fjaderboll/lora-beetle-e1/board/prototype.md

# Prototype
Home-made circuit board for testing only.
For the final one, look [here](README.md).

## Top
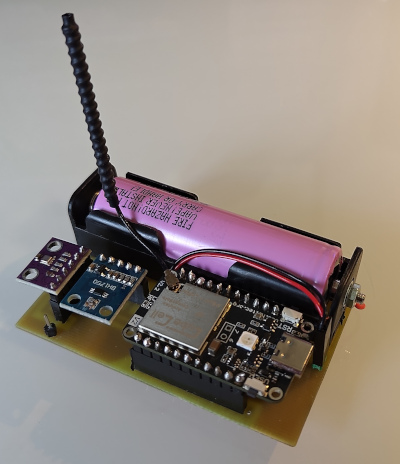
[picture p12: board/images/prototype-top.jpg]
Prototype board, top


## Bottom
Prototype board, bottom
