fjaderboll/lora-beetle-e1/doc/prototype.md

# Prototype
Home-made circuit board for testing only.
For the final one, look [here](../board/README.md).

## Top
Prototype board, top

## Bottom
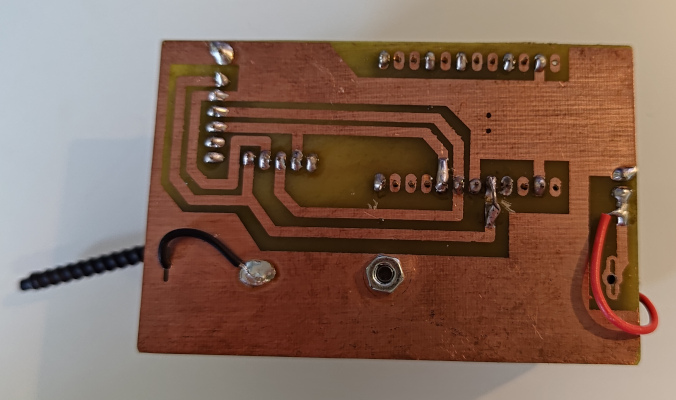
[picture p13: doc/prototype-bottom.jpg]
Prototype board, bottom
