fjaderboll/lora-beetle-e1/doc/cost.md

# Cost
Pricing includes taxes, but not shipping or other import fees.
Many items I bought in bundles.

| Item | Cost |
| ---- | ---- |
| [CubeCell HTCC-AB01_V2](https://docs.heltec.cn/en/node/asr650x/htcc_ab01/) (with antenna) | 193 SEK ($19.30) |
| BME280 (temperature, humidity, pressure sensor) | 52 SEK ($5.20) |
| BH1750 (light sensor) | 17 SEK ($1.70) |
| Lithium-ion battery 3.7V (18650) 3500 mAh | 40 SEK ($4.00) |
| Battery holder (Keystone 1042P) | 7 SEK ($0.70) |
| [Circuit board](../board/README.md) (ordered from PCBWay) | 30 SEK ($3.00) |
| Pin headers, 2.54 mm (female 2× 1×11, 1×6, 1×5, 1×2; male 1×2) | 6 SEK ($0.60) |
| Filament for [case](../case/README.md) (~80 g) | 25 SEK ($2.50) |
| **Total** | **370 SEK ($37)** |
