fjaderboll/lora-beetle-e1/board/pcb/lora-beetle-e1.kicad_pcb

## KiCad design board/pcb/lora-beetle-e1.kicad_pcb (2026-11-03)

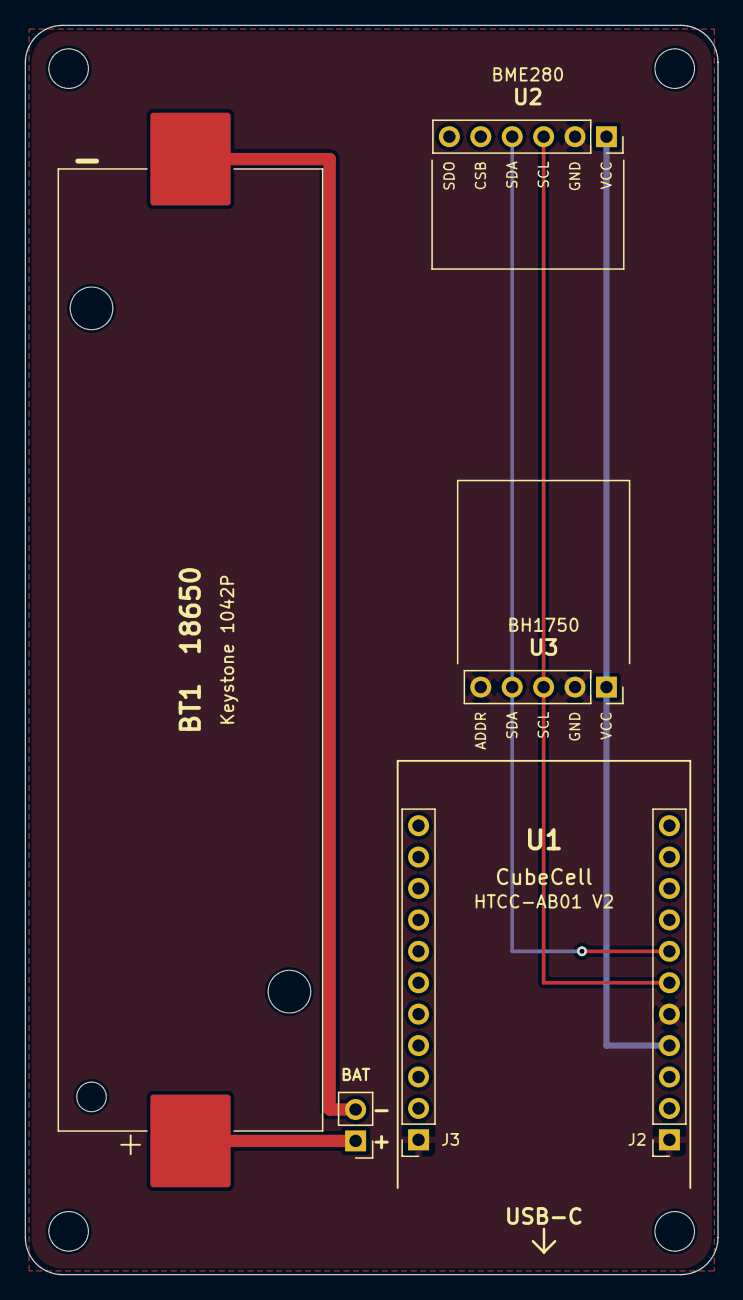
[picture p14: board lora-beetle-e1.kicad_pcb from above]

Board: 2 copper layers, 56.0 x 101.0 mm, 10 parts (0 on the bottom side), 6 nets.

Parts:
BT1: Keystone 1042P 18650; BatteryHolder_Keystone_1042_1x18650
H1, H2, H3, H4: M3; MountingHole_3.2mm_M3
J1: BAT; PinHeader_1x02_P2.54mm_Vertical
J2: CubeCell J2; PinSocket_1x11_P2.54mm_Vertical
J3: CubeCell J3; PinSocket_1x11_P2.54mm_Vertical
J4: BME280 (GY-BME280); PinSocket_1x06_P2.54mm_Vertical
J5: BH1750 (GY-302); PinSocket_1x05_P2.54mm_Vertical

Connections:
BAT+: BT1.1, J1.1
BAT-: BT1.2, J1.2
GND: J2.1, J2.5, J3.1, J4.2, J5.2, J5.5
SCL: J2.6, J4.3, J5.3
SDA: J2.7, J4.4, J5.4
VEXT: J2.4, J4.1, J5.1
