fjaderboll/lora-beetle-e1/lora-beetle-e1.ino

/*
 * lora-beetle-e1: LoRa environment sensor (CubeCell HTCC-AB01)
 *
 * Sensors:
 *   - BME280 (I2C): temperature, humidity, pressure
 *   - BH1750 (I2C): ambient light (lux)
 *
 * Behaviour:
 *   - OTAA join on power-up
 *   - Every uplink interval (default 15 min) wake up, read sensors,
 *     transmit an uplink, then go back to deep sleep. The interval
 *     can be changed by a downlink.
 *   - Pressing the USER button sends an extra uplink right away
 *     and restarts the interval. The RGB LED blinks blue to
 *     confirm the press, or red if it is ignored (an uplink is already
 *     pending, or the device hasn't joined yet).
 *
 * Region / sub-band must be selected in the Arduino IDE
 *   "Tools" menu (LoRaWAN Region, Class, etc.).
 *
 * Uplink payload (11 bytes, big-endian, port 2):
 *   [0..1] temperature * 100   (int16)   -- e.g. 2345 = 23.45 C
 *   [2..3] humidity    * 100   (uint16)  -- e.g. 5012 = 50.12 %
 *   [4..5] pressure    * 10    (uint16)  -- hPa * 10, e.g. 10132 = 1013.2 hPa
 *   [6..9] light (lux) * 100   (uint32)  -- e.g. 12345 = 123.45 lx
 *   [10]   battery level       (uint8)   -- CubeCell BoardGetBatteryLevel (0..254)
 *
 * Downlink payload (big-endian, port 2), see doc/downlink.md:
 *   [0]    command             (uint8)
 *   [1..]  parameters
 *   0x01 set uplink interval: [1..2] minutes (uint16, 1..1440)
 */

#include "LoRaWan_APP.h"
#include "Arduino.h"
#include <Wire.h>
#include <Adafruit_Sensor.h>
#include <Adafruit_BME280.h>
#include <BH1750.h>
#include <CubeCell_NeoPixel.h>
#include "keys.h"

// Fallbacks for keys.h files predating the defaults
#ifndef DEFAULT_APP_EUI
#define DEFAULT_APP_EUI { 0 }
#endif
#ifndef DEFAULT_APP_KEY
#define DEFAULT_APP_KEY { 0 }
#endif

/* ------------------------------------------------------------------ */
/* LoRaWAN keys                                                       */
/* ------------------------------------------------------------------ */
// OTAA credentials (don't modify here, go to keys.h)
uint8_t devEui[8] = { 0x00, 0x00, 0x00, 0x00, 0x00, 0x00, 0x00, 0x00 };
uint8_t appEui[8] = { 0x00, 0x00, 0x00, 0x00, 0x00, 0x00, 0x00, 0x00 };
uint8_t appKey[16] = {
	0x00, 0x00, 0x00, 0x00, 0x00, 0x00, 0x00, 0x00,
	0x00, 0x00, 0x00, 0x00, 0x00, 0x00, 0x00, 0x00
};

// ABP credentials (not used when overTheAirActivation=true, but kept for CubeCell compatibility)
uint8_t nwkSKey[] = {
	0x00, 0x00, 0x00, 0x00, 0x00, 0x00, 0x00, 0x00,
	0x00, 0x00, 0x00, 0x00, 0x00, 0x00, 0x00, 0x00
};
uint8_t appSKey[] = {
	0x00, 0x00, 0x00, 0x00, 0x00, 0x00, 0x00, 0x00,
	0x00, 0x00, 0x00, 0x00, 0x00, 0x00, 0x00, 0x00
};
uint32_t devAddr = 0x00000000;

/* ------------------------------------------------------------------ */
/* LoRaWAN configuration                                              */
/* ------------------------------------------------------------------ */

/* LoRaWAN region (override via Arduino IDE "Tools > LoRaWAN Region" menu).
 * The macro ACTIVE_REGION is supplied by the CubeCell board package. */
#ifndef ACTIVE_REGION
#define ACTIVE_REGION   LORAMAC_REGION_EU868
#endif
LoRaMacRegion_t loraWanRegion = ACTIVE_REGION;

/* Class A : end-device only opens RX windows after a TX. */
DeviceClass_t  loraWanClass    = CLASS_A;

/* Uplink interval: 15 minutes (in milliseconds). Changeable by downlink,
 * reverts to this value on reset. */
uint32_t appTxDutyCycle        = 15 * 60 * 1000;

/* OTAA activation. */
bool overTheAirActivation      = true;

/* Adaptive Data Rate. */
bool loraWanAdr                = true;

/* Don't save the session to flash. Only LoRaWAN.ifskipjoin() reads it back,
 * and this sketch always joins after a reset. The session survives deep
 * sleep in RAM. */
bool keepNet                   = false;

/* Unconfirmed uplinks (saves airtime / battery). */
bool isTxConfirmed             = false;

/* Application port. */
uint8_t appPort                = 2;

/* Confirmed-uplink retries (only relevant if isTxConfirmed = true). */
uint8_t confirmedNbTrials      = 4;

/* Sub-band selection for regions that need it (e.g. US915, AU915).
 * EU868 / AS923 / IN865 ignore this. The default mask enables the first
 * 8 channels; adjust if your network uses a different sub-band. */
uint16_t userChannelsMask[6]   = { 0x00FF, 0x0000, 0x0000, 0x0000, 0x0000, 0x0000 };

/* ------------------------------------------------------------------ */
/* Sensor objects                                                     */
/* ------------------------------------------------------------------ */

static Adafruit_BME280 bme;
static BH1750          lightMeter;

static bool bmeReady   = false;
static bool lightReady = false;

/* ------------------------------------------------------------------ */
/* User button                                                        */
/* ------------------------------------------------------------------ */

/* USER_KEY (P3_3) has an external pull-up; pressing pulls it low. */
static volatile bool buttonPressed = false;
static bool sendPending = false;   // press accepted, waiting for the MAC

static void onButtonPress()
{
	buttonPressed = true;
}

static void attachButton()
{
	pinMode(USER_KEY, INPUT);
	attachInterrupt(USER_KEY, onButtonPress, FALLING);
}

/* Wait for release so contact bounce isn't seen as another press. */
static void waitForButtonRelease()
{
	uint32_t start = millis();
	while (digitalRead(USER_KEY) == LOW && millis() - start < 2000) {
		delay(10);
	}
	delay(50);
	buttonPressed = false;
}

/* The onboard RGB LED is powered from Vext, like the sensors. Blink it
 * before measuring so it doesn't affect the BH1750 light reading. */
static CubeCell_NeoPixel statusLed(1, RGB, NEO_GRB + NEO_KHZ800);

#define LED_SENDING  0x000040   // blue: uplink will be sent
#define LED_IGNORED  0x400000   // red: press ignored (busy or not joined)

static void blinkLed(uint32_t color)
{
	pinMode(Vext, OUTPUT);
	digitalWrite(Vext, LOW);   // LOW = Vext ON
	delay(5);
	statusLed.begin();
	statusLed.setPixelColor(0, color);
	statusLed.show();
	delay(200);
	statusLed.clear();
	statusLed.show();
	digitalWrite(Vext, HIGH);
}

/* USER_KEY doubles as VBAT_ADC_CTL, which the battery measurement drives
 * low. Detach the button while measuring so it doesn't look like a press. */
static uint8_t readBatteryLevel()
{
	detachInterrupt(USER_KEY);
	uint8_t level = BoardGetBatteryLevel();
	attachButton();
	/* Also covers a real press that was still pending: this uplink serves it. */
	buttonPressed = false;
	sendPending = false;
	return level;
}

/* ------------------------------------------------------------------ */
/* Helpers                                                            */
/* ------------------------------------------------------------------ */

static bool isAllZero(const uint8_t *buf, int len)
{
	for (int i = 0; i < len; i++) {
		if (buf[i] != 0) {
			return false;
		}
	}
	return true;
}

static void printHex(const char *label, const uint8_t *buf, int len)
{
	Serial.print(label);
	for (int i = 0; i < len; i++) {
		Serial.printf("%02X", buf[i]);
	}
	Serial.println();
}

/* Resolve credentials per field: keyMap entry -> default (see keys.h). */
static void setupKeys()
{
	uint64_t chipId = getID();
	Serial.printf("ChipID: %04X%08X\n", (uint32_t)(chipId>>32), (uint32_t)chipId);

	// Defaults
	static const uint8_t defaultAppEui[8] = DEFAULT_APP_EUI;
	static const uint8_t defaultAppKey[16] = DEFAULT_APP_KEY;
	LoRaWAN.generateDeveuiByChipID();
	memcpy(appEui, defaultAppEui, sizeof(appEui));
	memcpy(appKey, defaultAppKey, sizeof(appKey));

	// Per-device overrides, all-zero fields are left at their defaults
	for (int i = 0; i < keyMapSize; i++) {
		const KeyMapping *k = &keyMap[i];
		if (k->chipId != chipId) {
			continue;
		}
		Serial.println("Chip ID found in key map");
		if (!isAllZero(k->devEui, sizeof(k->devEui))) {
			memcpy(devEui, k->devEui, sizeof(devEui));
		}
		if (!isAllZero(k->appEui, sizeof(k->appEui))) {
			memcpy(appEui, k->appEui, sizeof(appEui));
		}
		if (!isAllZero(k->appKey, sizeof(k->appKey))) {
			memcpy(appKey, k->appKey, sizeof(appKey));
		}
		break;
	}

	printHex("DevEUI: ", devEui, sizeof(devEui));
	printHex("AppEUI: ", appEui, sizeof(appEui));
	printHex("AppKey: ", appKey, sizeof(appKey));

	if (isAllZero(appKey, sizeof(appKey))) {
		Serial.println("WARNING: AppKey is all zeros, set DEFAULT_APP_KEY or a per-device appKey in keys.h");
	}
}

static void turnSensorPowerOn() {
	/* CubeCell powers external 3V3 (sensors) via the Vext pin. */
	pinMode(Vext, OUTPUT);
	digitalWrite(Vext, LOW);   // LOW = Vext ON
	delay(100); // wait for Vext to settle and sensors to boot
	Serial.println("Vext is on");
	Wire.begin();
}

static void turnSensorPowerOff() {
	/* Release the I2C bus first so SDA/SCL don't back-power the
	 * sensors through their pull-ups while Vext is off. */
	Wire.end();
	/* Turn off Vext to save power until next cycle. */
	digitalWrite(Vext, HIGH);
	Serial.println("Vext is off");
}

static void initSensors()
{
	turnSensorPowerOn();

	/* BME280 default I2C address is 0x76, fall back to 0x77. */
	bmeReady = bme.begin(0x76, &Wire) || bme.begin(0x77, &Wire);
	if (bmeReady) {
		/* Weather-station preset: 1x oversampling, forced mode, filter off. */
		bme.setSampling(Adafruit_BME280::MODE_FORCED,
		                Adafruit_BME280::SAMPLING_X1,   // temp
		                Adafruit_BME280::SAMPLING_X1,   // pressure
		                Adafruit_BME280::SAMPLING_X1,   // humidity
		                Adafruit_BME280::FILTER_OFF);
	} else {
		Serial.println(F("BME280 not found"));
	}

	lightReady = lightMeter.begin(BH1750::ONE_TIME_HIGH_RES_MODE);
	if (!lightReady) {
		Serial.println(F("BH1750 not found"));
	}
}

static void writeUint16BE(uint8_t *buf, uint16_t v)
{
	buf[0] = (uint8_t)(v >> 8);
	buf[1] = (uint8_t)(v & 0xFF);
}

static void writeUint32BE(uint8_t *buf, uint32_t v)
{
	buf[0] = (uint8_t)(v >> 24);
	buf[1] = (uint8_t)(v >> 16);
	buf[2] = (uint8_t)(v >> 8);
	buf[3] = (uint8_t)(v & 0xFF);
}

/* Build the uplink payload from a fresh sensor read. */
static void prepareTxFrame(uint8_t port)
{
	(void)port;

	initSensors();

	float tempC      = 0.0f;
	float humidity   = 0.0f;
	float pressureHp = 0.0f;
	float lux        = 0.0f;

	if (bmeReady) {
		/* Forced mode: trigger one measurement and read it back. */
		bme.takeForcedMeasurement();
		tempC      = bme.readTemperature();          // °C
		humidity   = bme.readHumidity();             // %
		pressureHp = bme.readPressure() / 100.0f;    // Pa -> hPa
	}

	if (lightReady) {
		/* ONE_TIME mode: re-arm and wait for a fresh sample.
		 * High-res measurement takes ~120 ms. */
		lightMeter.configure(BH1750::ONE_TIME_HIGH_RES_MODE);
		delay(180);
		lux = lightMeter.readLightLevel();
		if (lux < 0) {
			lux = 0;
		}
	}

	int16_t  tempScaled  = (int16_t)lroundf(tempC * 100.0f);
	uint16_t humScaled   = (uint16_t)lroundf(humidity * 100.0f);
	uint16_t pressScaled = (uint16_t)lroundf(pressureHp * 10.0f);
	uint32_t luxScaled   = (uint32_t)lroundf(lux * 100.0f);
	uint8_t  battery     = readBatteryLevel();

	appDataSize = 11;
	writeUint16BE(&appData[0], (uint16_t)tempScaled);
	writeUint16BE(&appData[2], humScaled);
	writeUint16BE(&appData[4], pressScaled);
	writeUint32BE(&appData[6], luxScaled);
	appData[10] = battery;

	Serial.printf("T=%.2f C  RH=%.2f %%  P=%.2f hPa  L=%.2f lx  bat=%u\n",
	              tempC, humidity, pressureHp, lux, battery);

	turnSensorPowerOff();
}

/* (Re)start the uplink interval, with a small random jitter (0..1 s). */
static void scheduleNextUplink()
{
	txDutyCycleTime = appTxDutyCycle + randr(0, 1000);
	LoRaWAN.cycle(txDutyCycleTime);
}

/* ------------------------------------------------------------------ */
/* Downlink commands (see doc/downlink.md)                            */
/* ------------------------------------------------------------------ */

#define DOWNLINK_PORT            2

#define CMD_SET_UPLINK_INTERVAL  0x01

/* The CubeCell RTC alarm can't be set more than ~36 h ahead, so a single
 * LoRaWAN.cycle() must stay below that. */
#define MIN_UPLINK_INTERVAL_MIN  1
#define MAX_UPLINK_INTERVAL_MIN  (24 * 60)

static uint16_t readUint16BE(const uint8_t *buf)
{
	return ((uint16_t)buf[0] << 8) | buf[1];
}

static void setUplinkInterval(const uint8_t *params, uint8_t len)
{
	if (len != 2) {
		Serial.printf("Set uplink interval error: expected 2 parameter bytes, got %u\n", len);
		return;
	}
	uint16_t minutes = readUint16BE(params);
	if (minutes < MIN_UPLINK_INTERVAL_MIN || minutes > MAX_UPLINK_INTERVAL_MIN) {
		Serial.printf("Set uplink interval error: %u min out of range (%u..%u), ignoring update\n",
		              minutes, MIN_UPLINK_INTERVAL_MIN, MAX_UPLINK_INTERVAL_MIN);
		return;
	}
	appTxDutyCycle = (uint32_t)minutes * 60 * 1000;
	Serial.printf("Uplink interval set to %u min\n", minutes);
	/* The interval for the uplink that carried this downlink is already
	 * running, restart it so the new value applies right away. */
	scheduleNextUplink();
}

/* Overrides the CubeCell weak handler, called for every downlink with data. */
void downLinkDataHandle(McpsIndication_t *mcpsIndication)
{
	const uint8_t *buf = mcpsIndication->Buffer;
	uint8_t len = mcpsIndication->BufferSize;

	Serial.printf("Downlink on port %u: ", mcpsIndication->Port);
	printHex("", buf, len);

	if (mcpsIndication->Port != DOWNLINK_PORT || len == 0) {
		Serial.println("Downlink ignored");
		return;
	}

	switch (buf[0]) {
		case CMD_SET_UPLINK_INTERVAL: {
			setUplinkInterval(&buf[1], len - 1);
			break;
		}
		default: {
			Serial.printf("Unknown downlink command 0x%02X\n", buf[0]);
			break;
		}
	}
}

/* ------------------------------------------------------------------ */
/* Arduino entry points                                               */
/* ------------------------------------------------------------------ */

void setup()
{
	Serial.begin(115200);
	delay(10);

	setupKeys();
	attachButton();

	/* Always do a fresh OTAA join after a reset or power-up. */
	deviceState = DEVICE_STATE_INIT;
}

void loop()
{
	switch (deviceState) {
		case DEVICE_STATE_INIT: {
			LoRaWAN.init(loraWanClass, loraWanRegion);
			break;
		}
		case DEVICE_STATE_JOIN: {
			Serial.printf("DevEui: %02X%02X%02X%02X%02X%02X%02X%02X\n",
				devEui[0],devEui[1],devEui[2],devEui[3],
				devEui[4],devEui[5],devEui[6],devEui[7]);
			LoRaWAN.join();
			break;
		}
		case DEVICE_STATE_SEND: {
			prepareTxFrame(appPort);
			LoRaWAN.send();
			deviceState = DEVICE_STATE_CYCLE;
			break;
		}
		case DEVICE_STATE_CYCLE: {
			scheduleNextUplink();
			deviceState = DEVICE_STATE_SLEEP;
			break;
		}
		case DEVICE_STATE_SLEEP: {
			if (buttonPressed) {
				if (IsLoRaMacNetworkJoined && !sendPending) {
					Serial.println("Button pressed, sending uplink");
					blinkLed(LED_SENDING);
					sendPending = true;
				} else {
					Serial.println("Button pressed, ignored");
					blinkLed(LED_IGNORED);
				}
				waitForButtonRelease();
			}
			/* The previous uplink may still be in progress (RX windows,
			 * duty-cycle delay); LoRaWAN.send() silently drops the frame
			 * then. Keep the press pending, the MAC timers wake us up. */
			if (sendPending && LoRaMacState == LORAMAC_IDLE) {
				sendPending = false;
				deviceState = DEVICE_STATE_SEND;
				break;
			}
			/* Let the UART drain, deep sleep cuts off pending output. */
			Serial.flush();
			LoRaWAN.sleep();
			break;
		}
		default: {
			deviceState = DEVICE_STATE_INIT;
			break;
		}
	}
}
