fjaderboll/lora-beetle-e1/(commit log)

2026-10-16 User buttons sends uplink immediately
2026-10-16 Added wiring doc
2026-10-16 Created circuit board
2026-10-17 Prototype images
2026-10-18 Battery calculations
2026-10-21 Battery doc tweak
2026-10-22 Case, first draft
2026-10-22 Lowering case base height with 3.5 mm
2026-10-22 Case render
2026-10-29 Case, base part board fit adjustments
2026-10-29 Case, lid improvements
2026-10-29 Case doc updates
2026-10-31 Case update, improved stability of usb-port cover
2026-10-31 Case update, improved antenna holder
2026-10-31 Case update, reset button now reachable when lid is off
2026-10-31 Case update, OpenSCAD preview fix
2026-10-31 Case update, new board clip design
2026-11-02 Case update, off center screw hole
2026-11-06 Assembly updates
